revspace/lichtknop/(commit log)

2017-11-08 initial version, full of mistakes
    [lichtknop.ino]
2017-11-08 Docs! Schematics! Also, a pin changed.
2017-11-08 weird issue just got fixed. maybe. I think.
    [lichtknop.ino]
2017-11-13 Tijdlogica fixen, werkte helemaal niet.
    [lichtknop.ino]
2022-09-14 Initial esp8266 code
    Written by joepie91, probably in 2018
    Based on ledspace by f0x
2025-01-21 Wijzigingen uit 2022 die ik vergeten was te committen
